BIRDSOpenSource/BIRDS3-SolarPanel/README.md

<div align="center">
  <a href="https://lean-sat.org/opensource/">
  
  </a>
</div>

 

# BIRDS3-SolarPanel
 Documentation for the Solar Panel Boards used in the BIRDS3 Satellite

## About the BIRDS3 Program:

The project was led by Kyushu Institute of Technology in Japan and involves students from Sri Lanka, Bhutan, Nepal and Japan.
Satellite Names: NepaliSat-1 (Nepal), Raavana-1 (Sri Lanka) and Ugiusu (Japan)

Stakeholders: Nepal Academy of Science and Technology (NAST) for Nepal, Arthur C Clarke Institute for Modern Technologies (ACCIMT) for Sri Lanka, and Kyushu Institute of Technology (Kyutech) for Japan.

Project duration: 2018-2020

CubeSat: 1U (10x10x10) cm3

Weight: 1.13kg

Launch Date: 17th April 2019

BIRDS-3 has 4 main missions in total; LoRa Demonstration Mission (LDM), Imaging Mission (CAM), Attitude Determination and Control Mission (ADCS) and Software Configurable Backplane Mission (BPB) 

## Organisation structure

## Features

## I like this project, can I help you?
You are welcome 🙂

* Give us a star ⭐
* Watch repository to be notified about updates 👀
* If you will find some errors, report them in Issues 🐞
* Try Birds designs on some real computer and let us know how it worked in Discussions. 💬
* We would greatly appreciate if you would also tell others about this ecosystem, it helps us to improve BIRDS Open Source. Thank you!
