BIRDSOpenSource/BIRDS3-SolarPanel/SolarPanel_Partslist.xlsx

Sheet: +X panel
S.l No. | Component Name | Component in the Design | Value | Manufacturer part number | Pakage type | Manufacturer | Vendor | No. of units required per panel | Component website link
1 | KEMET Multilayer ceramic capacitor (MLCC) 16 V dc | C1, C2 | 1μF ± 10% | C0805C105K4RACTU | 0805(2012M) | KEMET | RS | 2 | https://jp.rs-online.com/web/p/ceramic-multilayer-capacitors/4515770/
2 | DIODE SCHOTTKY 20V 1A SOD123 | D1, D2 | 20V, 1A | NRVB120VLSFT1G | SOD-123F | ON Semiconductor | DigiKey | 2 | https://www.digikey.jp/product-detail/en/on-semiconductor/NRVB120VLSFT1G/NRVB120VLSFT1GOSCT-ND/8538727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
3 | SENSOR TEMP ANLG VOLT SC-70 | U$3 | 1.5 - 5.5V | LMT84QDCKTQ1 | 5-TSSOP, SC-70-5, SOT-353 | Texas Instruments | DigiKey | 1 | https://www.digikey.jp/products/en?keywords=296-36413-1-ND
4 | 12PIN Connector | U$1 | 12PIN | FSM-21045-12 | FSM-21045-12 | Hirosugi | Hirosugi | 1 | http://hirosugi.co.jp/products/N/FSM-20.html
5 | RES 1K OHM 1% 1 / 10W 0402 | R1 | 1k ± 1% | RK73H1ETTP1001F | 0402(1005) | KOA | Digikey | 1 | https://www.digikey.jp/product-detail/ja/koa-speer-electronics-inc/RK73H1ETTP1001F/2019-RK73H1ETTP1001FCT-ND/9846199

Sheet: +Y Panel
S.l No. | Component Name | Component in the Design | Value | Manufacturer part number | Pakage type | Manufacturer | Vendor | No. of units required per panel | Component website link
1 | KEMET Multilayer ceramic capacitor (MLCC) 16 V dc | C1, C2 | 1μF ± 10% | C0805C105K4RACTU | 0805(2012M) | KEMET | RS | 2 | https://jp.rs-online.com/web/p/ceramic-multilayer-capacitors/4515770/
2 | DIODE SCHOTTKY 20V 1A SOD123 | D1 | 20V, 1A | NRVB120VLSFT1G | SOD-123F | ON Semiconductor | DigiKey | 1 | https://www.digikey.jp/product-detail/en/on-semiconductor/NRVB120VLSFT1G/NRVB120VLSFT1GOSCT-ND/8538727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
3 | SENSOR TEMP ANLG VOLT SC-70 | U$3 | 1.5 - 5.5V | LMT84QDCKTQ1 | 5-TSSOP, SC-70-5, SOT-353 | Texas Instruments | DigiKey | 1 | https://www.digikey.jp/products/en?keywords=296-36413-1-ND
4 | 12PIN Connector | U$1 | 12PIN | FSM-21045-12 | FSM-21045-12 | Hirosugi | Hirosugi | 1 | http://hirosugi.co.jp/products/N/FSM-20.html
5 | RES 1K OHM 1% 1 / 10W 0402 | R1 | 1k ± 1% | RK73H1ETTP1001F | 0402(1005) | KOA | Digikey | 1 | https://www.digikey.jp/product-detail/ja/koa-speer-electronics-inc/RK73H1ETTP1001F/2019-RK73H1ETTP1001FCT-ND/9846199

Sheet: +Z Panel
S.l No. | Component Name | Component in the Design | Value | Manufacturer part number | Pakage type | Manufacturer | Vendor | No. of units required per panel | Component website link
1 | KEMET Multilayer ceramic capacitor (MLCC) 16 V dc | C1, C2 | 1μF ± 10% | C0805C105K4RACTU | 0805(2012M) | KEMET | RS | 2 | https://jp.rs-online.com/web/p/ceramic-multilayer-capacitors/4515770/
2 | DIODE SCHOTTKY 20V 1A SOD123 | D1, D2 | 20V, 1A | NRVB120VLSFT1G | SOD-123F | ON Semiconductor | DigiKey | 2 | https://www.digikey.jp/product-detail/en/on-semiconductor/NRVB120VLSFT1G/NRVB120VLSFT1GOSCT-ND/8538727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
3 | SENSOR TEMP ANLG VOLT SC-70 | U$3 | 1.5 - 5.5V | LMT84QDCKTQ1 | 5-TSSOP, SC-70-5, SOT-353 | Texas Instruments | DigiKey | 1 | https://www.digikey.jp/products/en?keywords=296-36413-1-ND
4 | 12PIN Connector | U$1 | 12PIN | FSM-21045-12 | FSM-21045-12 | Hirosugi | Hirosugi | 1 | http://hirosugi.co.jp/products/N/FSM-20.html
5 | RES 1K OHM 1% 1 / 10W 0402 | R1 | 1k ± 1% | RK73H1ETTP1001F | 0402(1005) | KOA | Digikey | 1 | https://www.digikey.jp/product-detail/ja/koa-speer-electronics-inc/RK73H1ETTP1001F/2019-RK73H1ETTP1001FCT-ND/9846199

Sheet: -Y Panel
S.l No. | Component Name | Component in the Design | Value | Manufacturer part number | Pakage type | Manufacturer | Vendor | No. of units required per panel | Component website link
1 | KEMET Multilayer ceramic capacitor (MLCC) 16 V dc | C1, C2 | 1μF ± 10% | C0805C105K4RACTU | 0805(2012M) | KEMET | RS | 2 | https://jp.rs-online.com/web/p/ceramic-multilayer-capacitors/4515770/
2 | DIODE SCHOTTKY 20V 1A SOD123 | D1 | 20V, 1A | NRVB120VLSFT1G | SOD-123F | ON Semiconductor | DigiKey | 1 | https://www.digikey.jp/product-detail/en/on-semiconductor/NRVB120VLSFT1G/NRVB120VLSFT1GOSCT-ND/8538727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
3 | SENSOR TEMP ANLG VOLT SC-70 | U$3 | 1.5 - 5.5V | LMT84QDCKTQ1 | 5-TSSOP, SC-70-5, SOT-353 | Texas Instruments | DigiKey | 1 | https://www.digikey.jp/products/en?keywords=296-36413-1-ND
4 | 12PIN Connector | U$1 | 12PIN | FSM-21045-12 | FSM-21045-12 | Hirosugi | Hirosugi | 1 | http://hirosugi.co.jp/products/N/FSM-20.html
5 | RES 1K OHM 1% 1 / 10W 0402 | R1 | 1k ± 1% | RK73H1ETTP1001F | 0402(1005) | KOA | Digikey | 1 | https://www.digikey.jp/product-detail/ja/koa-speer-electronics-inc/RK73H1ETTP1001F/2019-RK73H1ETTP1001FCT-ND/9846199

Sheet: -Z Panel
S.l No. | Component Name | Component in the Design | Value | Manufacturer part number | Pakage type | Manufacturer | Vendor | No. of units required per panel | Component website link
1 | KEMET Multilayer ceramic capacitor (MLCC) 16 V dc | C1, C2 | 1μF ± 10% | C0805C105K4RACTU | 0805(2012M) | KEMET | RS | 2 | https://jp.rs-online.com/web/p/ceramic-multilayer-capacitors/4515770/
2 | DIODE SCHOTTKY 20V 1A SOD123 | D1 | 20V, 1A | NRVB120VLSFT1G | SOD-123F | ON Semiconductor | DigiKey | 1 | https://www.digikey.jp/product-detail/en/on-semiconductor/NRVB120VLSFT1G/NRVB120VLSFT1GOSCT-ND/8538727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
3 | SENSOR TEMP ANLG VOLT SC-70 | U$3 | 1.5 - 5.5V | LMT84QDCKTQ1 | 5-TSSOP, SC-70-5, SOT-353 | Texas Instruments | DigiKey | 1 | https://www.digikey.jp/products/en?keywords=296-36413-1-ND
4 | 12PIN Connector | U$1 | 12PIN | FSM-21045-12 | FSM-21045-12 | Hirosugi | Hirosugi | 1 | http://hirosugi.co.jp/products/N/FSM-20.html
5 | RES 1K OHM 1% 1 / 10W 0402 | R1 | 1k ± 1% | RK73H1ETTP1001F | 0402(1005) | KOA | Digikey | 1 | https://www.digikey.jp/product-detail/ja/koa-speer-electronics-inc/RK73H1ETTP1001F/2019-RK73H1ETTP1001FCT-ND/9846199
