BIRDSOpenSource/BIRDS3-SolarPanel/Solar Panel Design/+Z panel/+Zpanel/+Z SOLAR PANEL.brd

## EAGLE design Solar Panel Design/+Z panel/+Zpanel/+Z SOLAR PANEL.brd (2021-10-05)

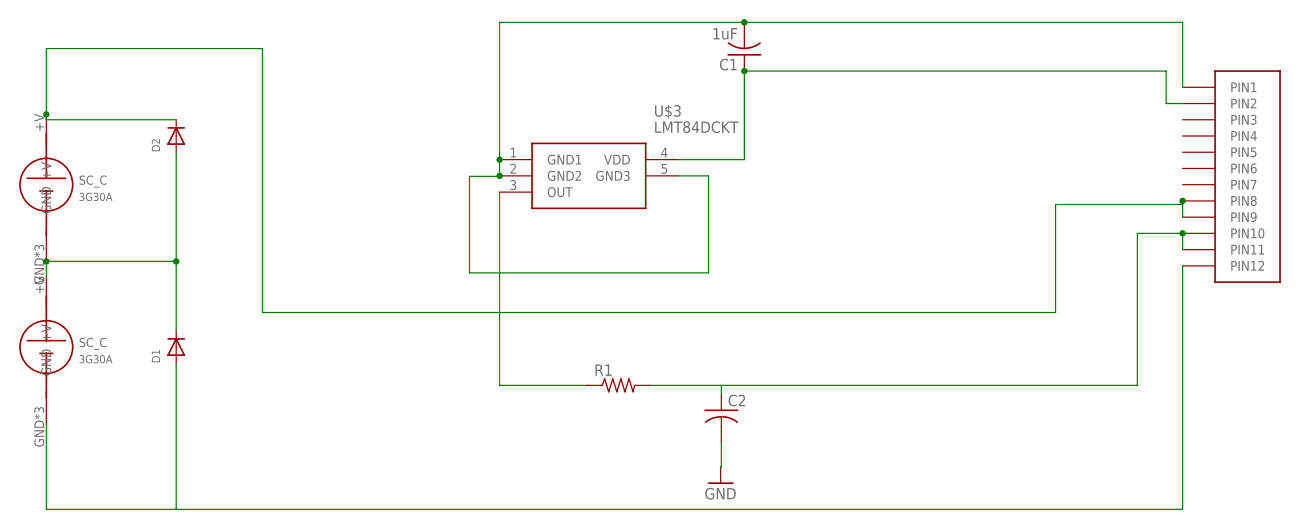
[picture p1: schematic +Z SOLAR PANEL.sch]

Parts:
C1: 1uF; C2012
C2: C-USC2012; C2012
D1, D2: DIODE_SOD-123FL; SOD-123FL
R1: R-US_R0402; R0402
U$1: HEADER12PIN
U$3: LMT84DCKT; SOT65P210X110-5N
U$4, U$5: SC_C

Connections:
+V: D2.C, U$1.P8 (PIN8), U$1.P9 (PIN9), U$4.+V
+VB: D1.C, D2.A, U$4.GND, U$4.GND1 (GND), U$4.GND2 (GND), U$5.+V
GND: C1.2, C2.2, D1.A, U$1.P1 (PIN1), U$1.P12 (PIN12), U$3.1 (GND1), U$3.2 (GND2), U$3.5 (GND3), U$5.GND, U$5.GND1 (GND), U$5.GND2 (GND)
unnamed: C1.1, U$1.P2 (PIN2), U$3.4 (VDD)
unnamed: R1.1, U$3.3 (OUT)
unnamed: C2.1, R1.2, U$1.P10 (PIN10), U$1.P11 (PIN11)

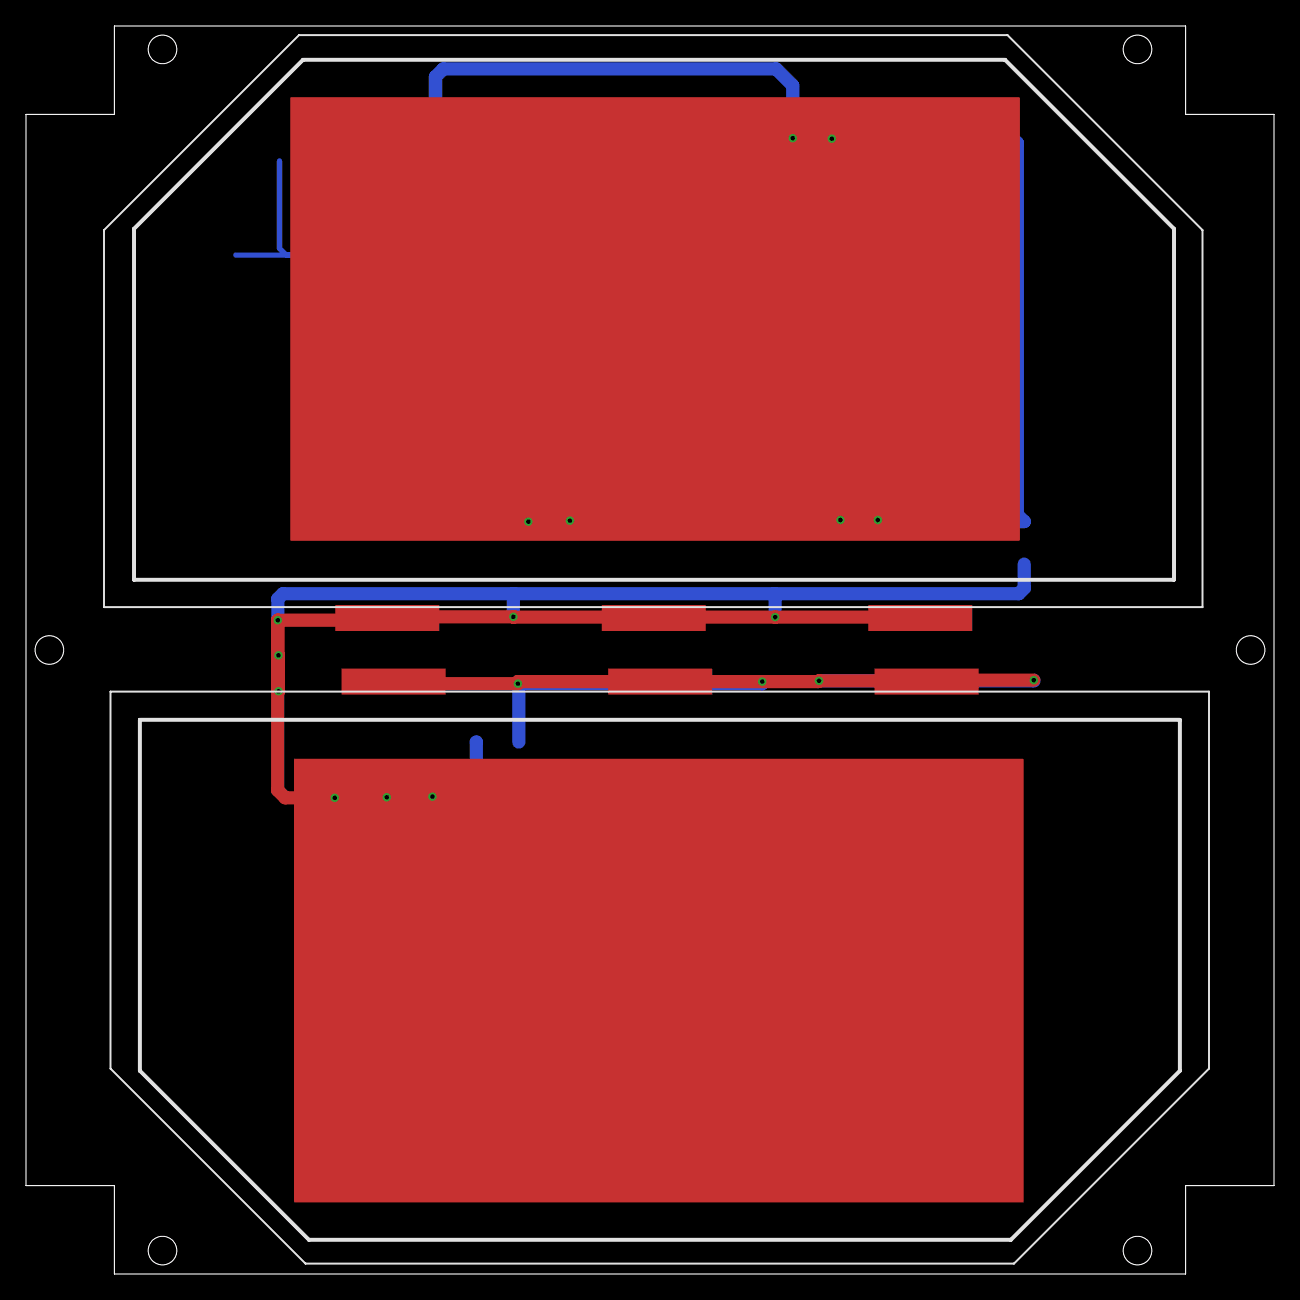
[picture p2: board +Z SOLAR PANEL.brd from above]

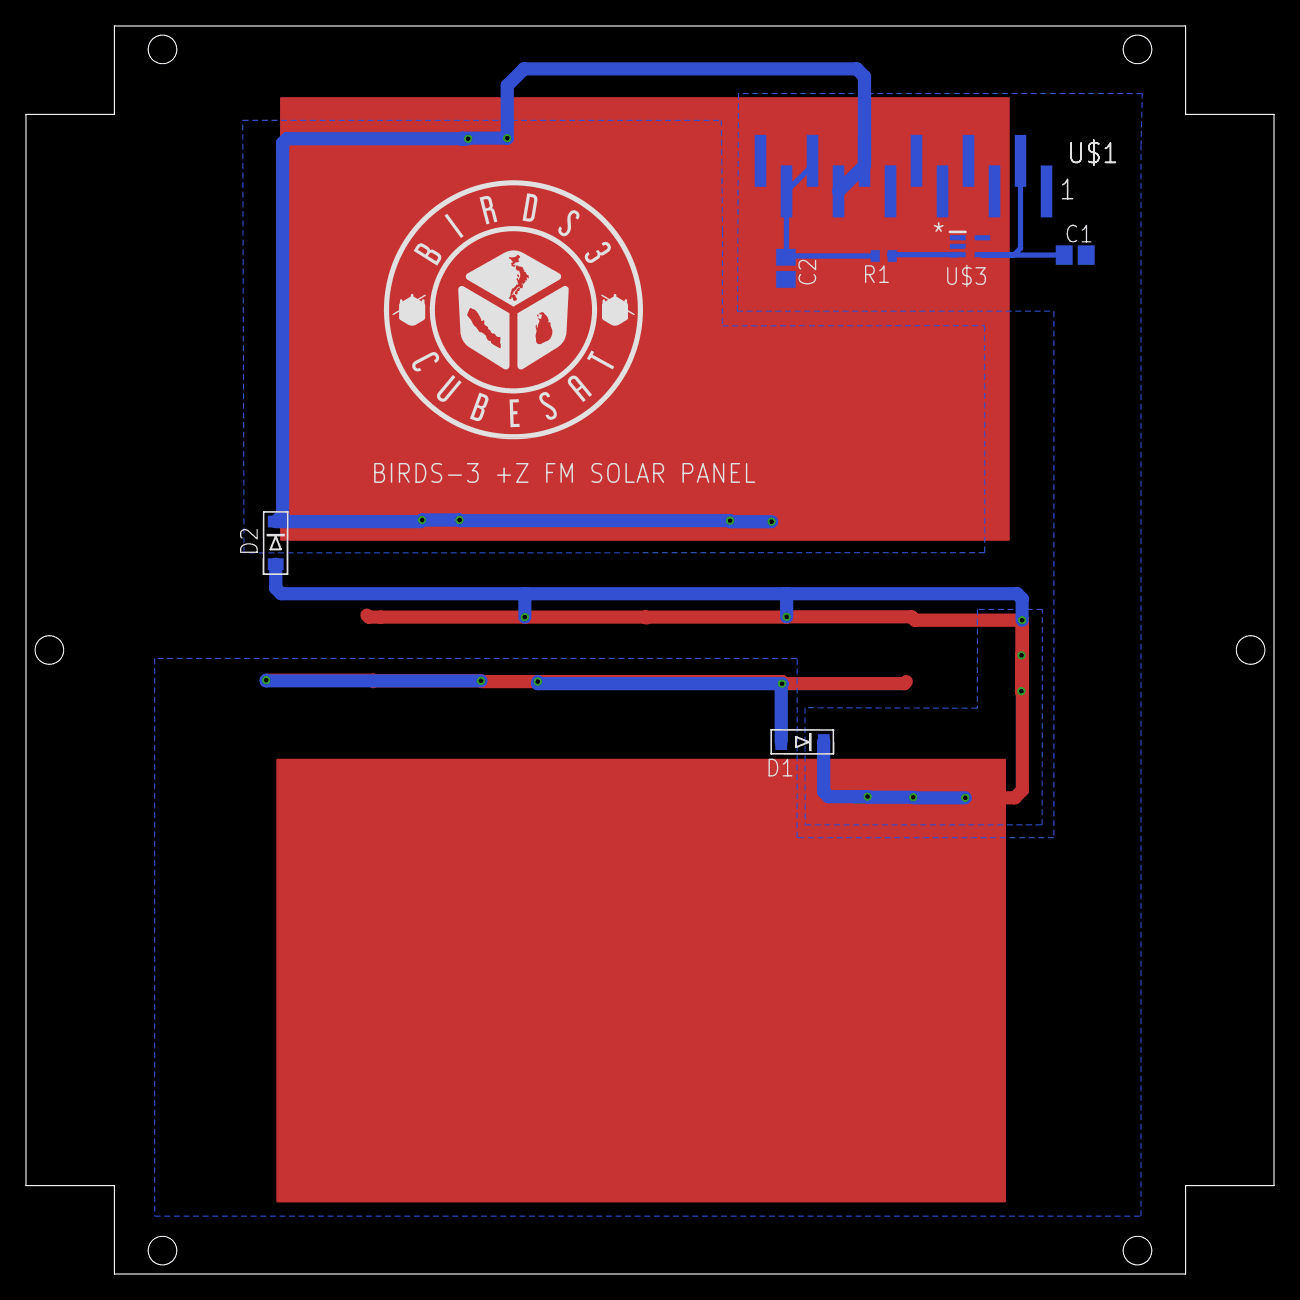
[picture p3: board +Z SOLAR PANEL.brd from below]

Board: 2 copper layers, 96.0 x 96.0 mm, 9 parts (5 on the bottom side), 6 nets.
