BIRDSOpenSource/BIRDS3-SolarPanel/Solar Panel Design/+Y panel/+YSOLAR PANEL.brd

## EAGLE design Solar Panel Design/+Y panel/+YSOLAR PANEL.brd (2021-10-05)

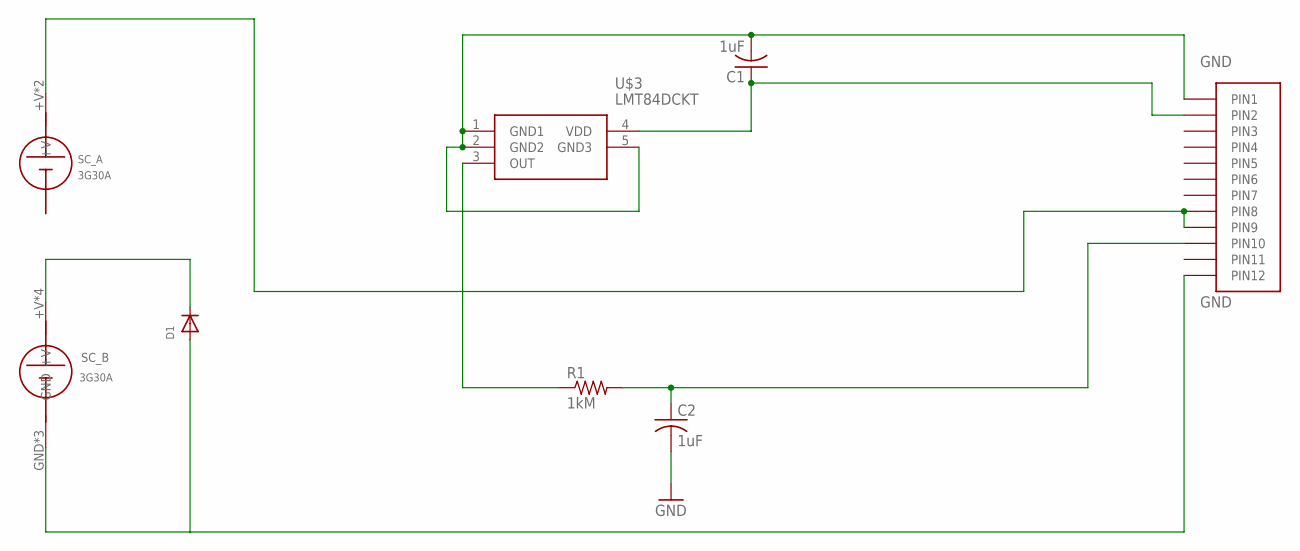
[picture p4: schematic +YSOLAR PANEL.sch]

Parts:
C1, C2: 1uF; C0805
D1: DIODE_SOD-123FL; SOD-123FL
R1: 1kM; R0402
SOLARCELL_A: SC_A
SOLARCELL_B: SC_B
U$1: HEADER12PIN
U$3: LMT84DCKT; SOT65P210X110-5N

Connections:
+V: SOLARCELL_A.+V, SOLARCELL_A.+V1, U$1.P8 (PIN8), U$1.P9 (PIN9)
+VB: D1.C, SOLARCELL_B.+V, SOLARCELL_B.+V2 (+V), SOLARCELL_B.+V3 (+V), SOLARCELL_B.+V4 (+V)
GND: C1.2, C2.2, D1.A, SOLARCELL_B.GND, SOLARCELL_B.GND1 (GND), SOLARCELL_B.GND2 (GND), U$1.P1 (PIN1), U$1.P12 (PIN12), U$3.1 (GND1), U$3.2 (GND2), U$3.5 (GND3)
unnamed: C1.1, U$1.P2 (PIN2), U$3.4 (VDD)
unnamed: R1.1, U$3.3 (OUT)
unnamed: C2.1, R1.2, U$1.P10 (PIN10)

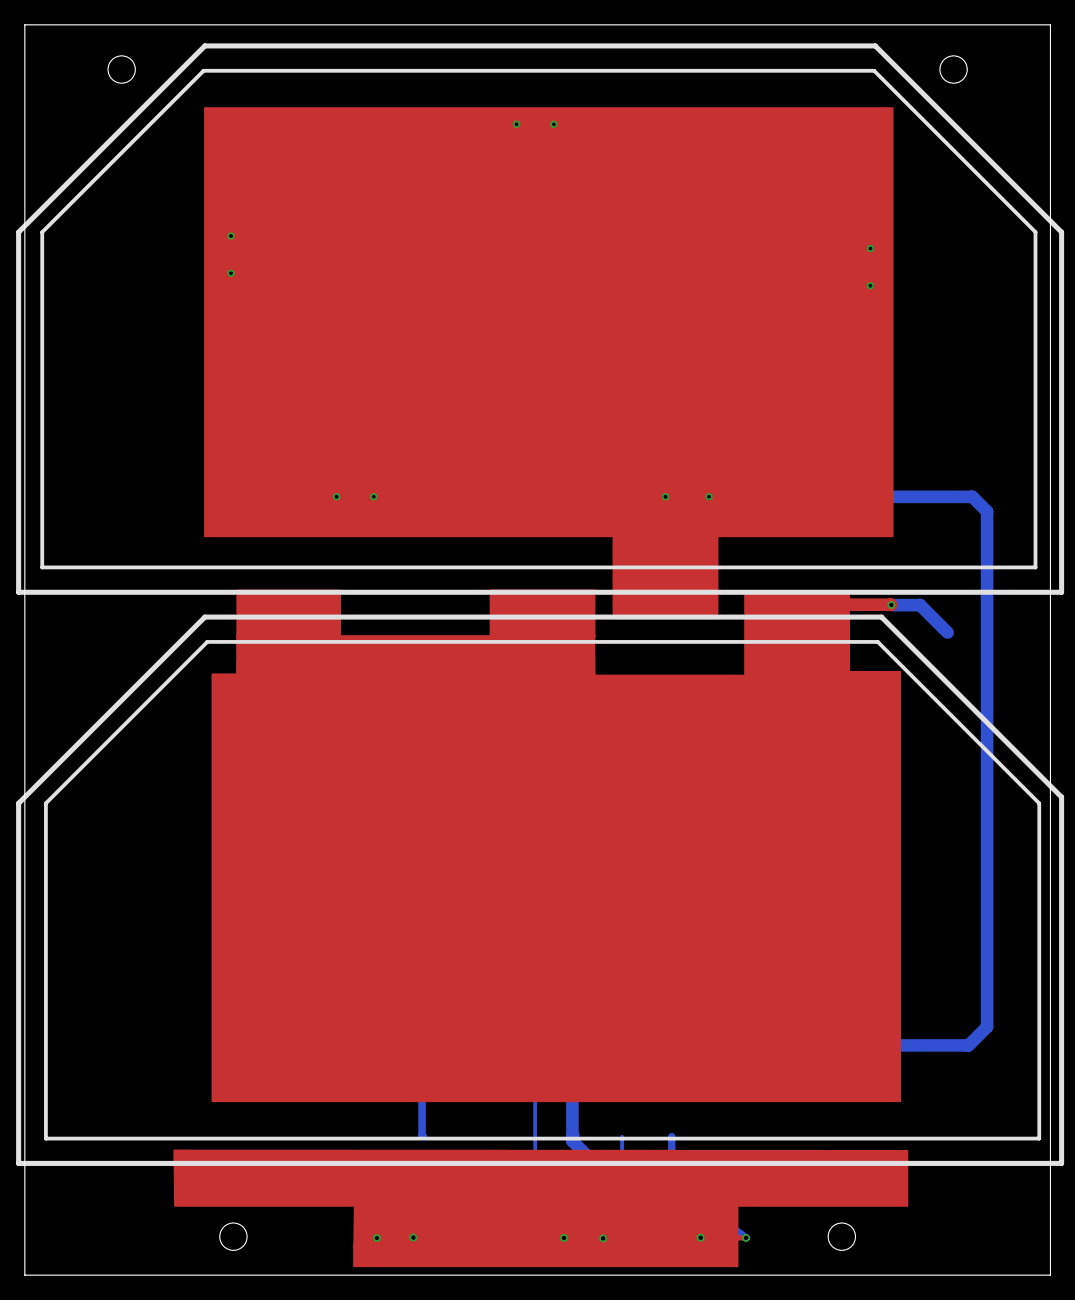
[picture p5: board +YSOLAR PANEL.brd from above]

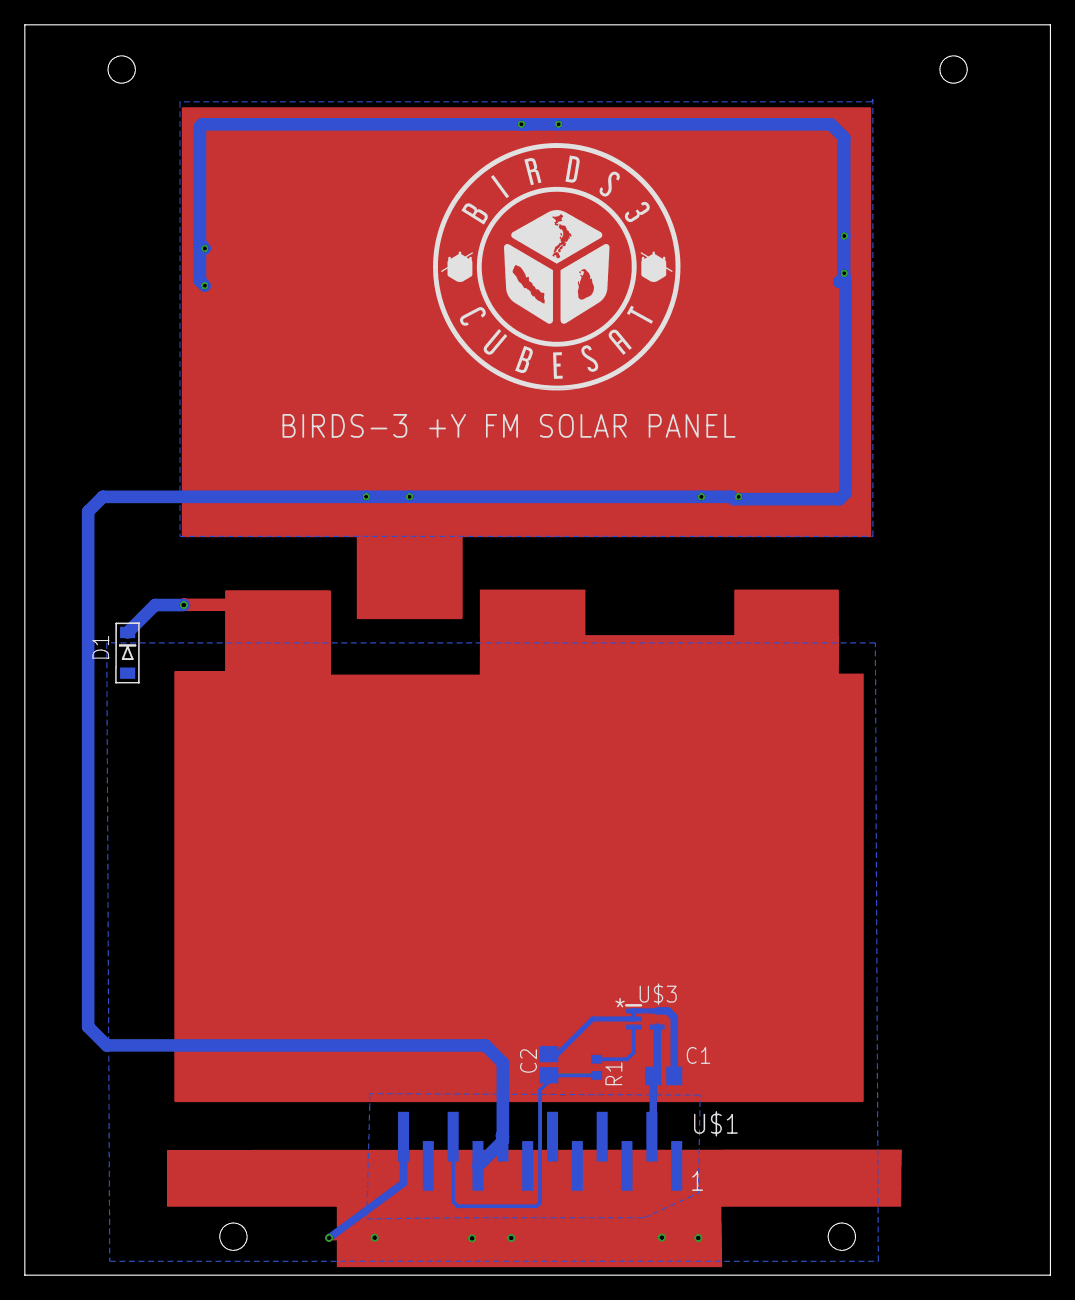
[picture p6: board +YSOLAR PANEL.brd from below]

Board: 2 copper layers, 82.6 x 100.7 mm, 8 parts (5 on the bottom side), 6 nets.
